HubertD/SAMC21-Base/SAMC21-Base.kicad_pcb

## KiCad design SAMC21-Base.kicad_pcb (2021-04-19)

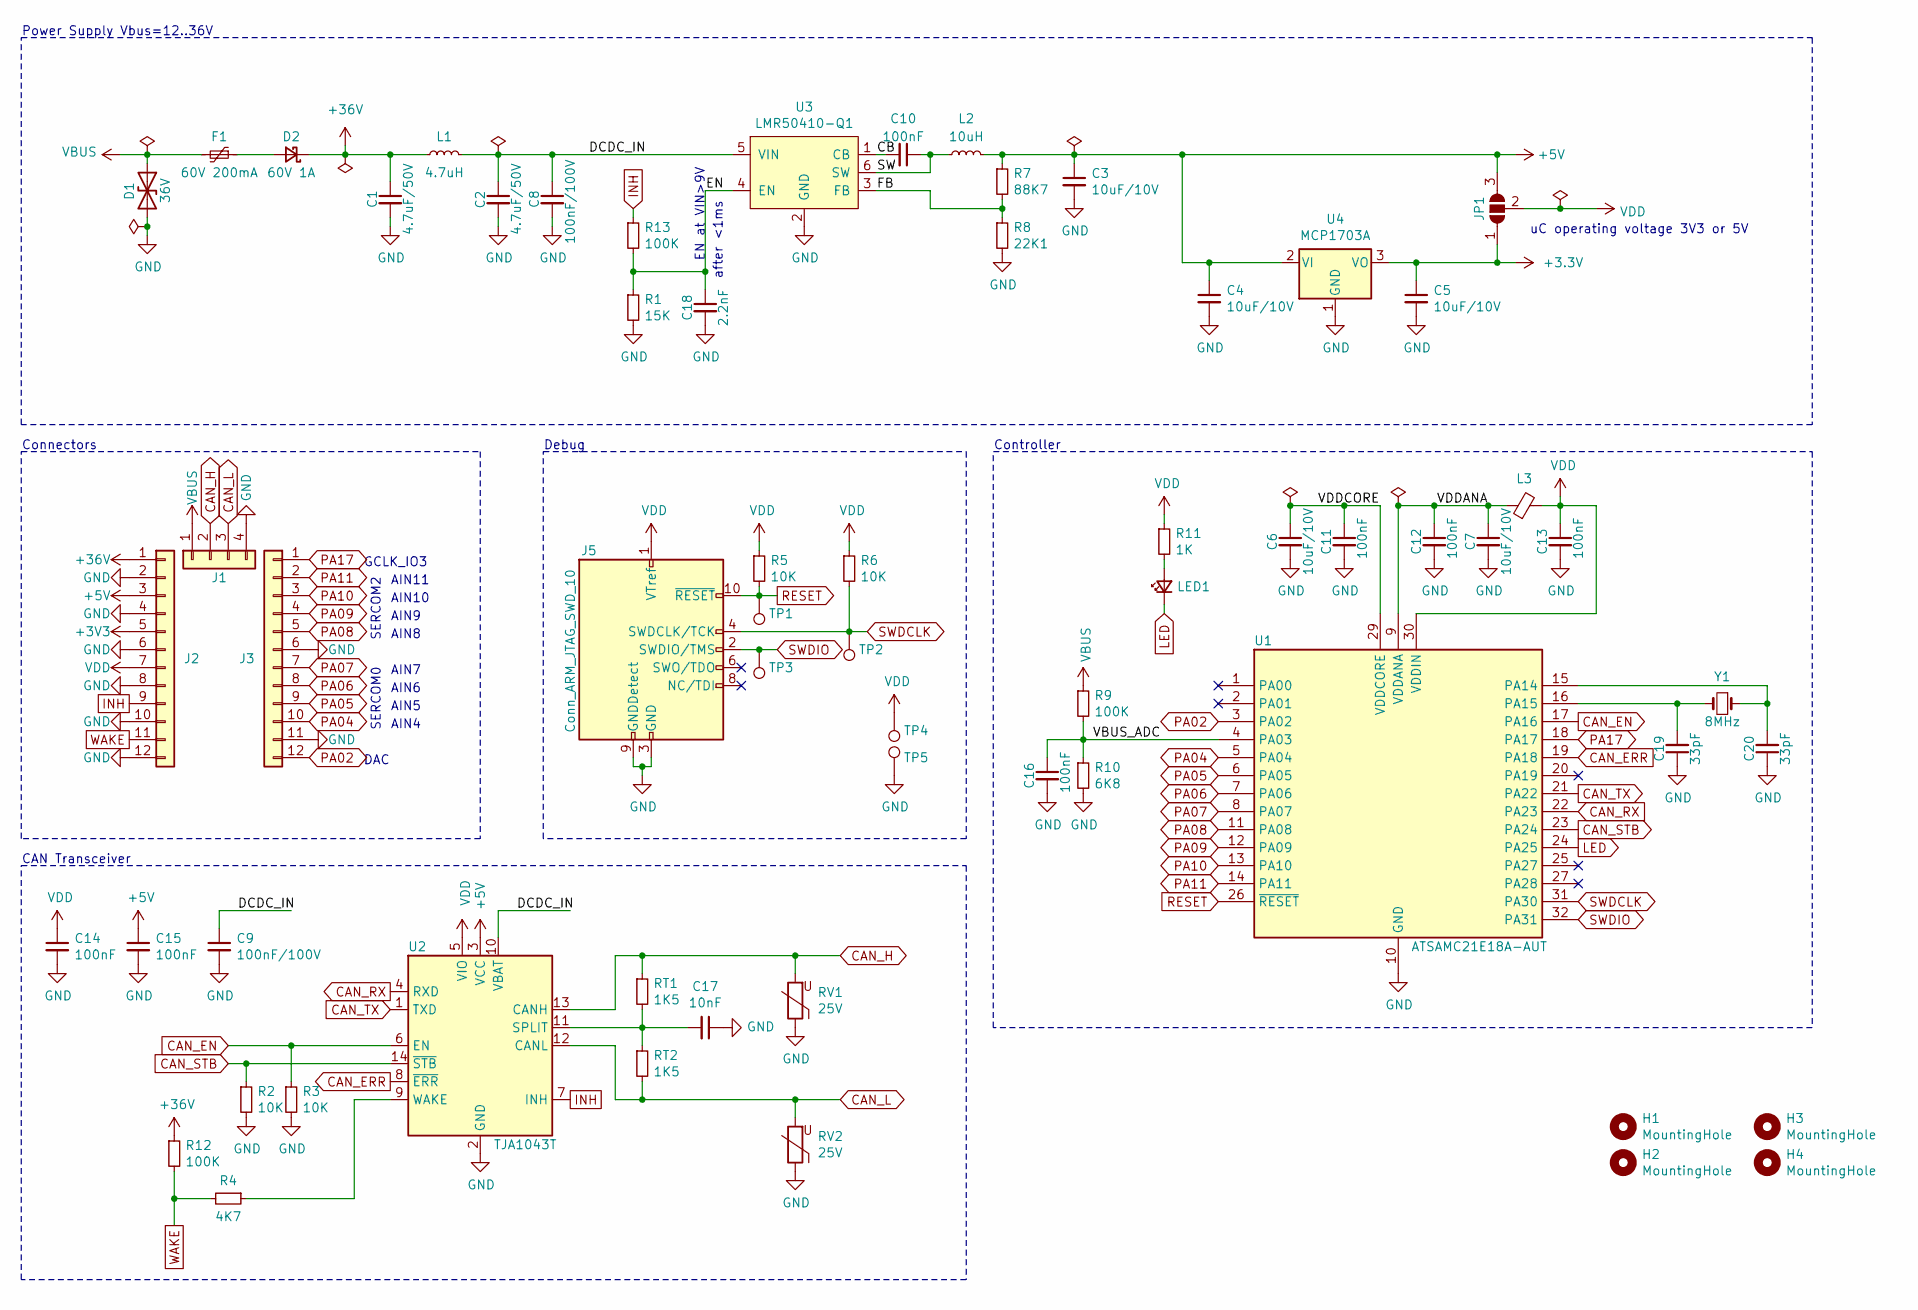
[picture p1: schematic SAMC21-Base.sch]

Parts:
C1, C2: 4.7uF/50V; C_1206_3216Metric
C3, C4, C5, C6, C7: 10uF/10V; C_0805_2012Metric
C8, C9: 100nF/100V; C_0603_1608Metric
C10, C11, C12, C13, C14, C15, C16: 100nF; C_0603_1608Metric
C17: 10nF; C_0603_1608Metric
C18: 2.2nF; C_0603_1608Metric
C19, C20: 33pF; C_0603_1608Metric
D1: 36V; D_SMA; MPN SMAJ36CA
D2: 60V 1A; D_SOD-123; MPN RB160MM-60TFTR
F1: 60V 200mA; Fuse_1812_4532Metric; MPN 1812L020/60
H1, H2, H3, H4: MountingHole; MountingHole_2.2mm_M2
J1: Conn_01x04; PinHeader_1x04_P2.54mm_Vertical
J2, J3: Conn_01x10; PinHeader_1x12_P2.54mm_Vertical
J5: Conn_ARM_JTAG_SWD_10; PinHeader_2x05_P1.27mm_Vertical_SMD
JP1: SolderJumper_3_Open; SolderJumper-3_P1.3mm_Open_RoundedPad1.0x1.5mm
L1: 4.7uH; L_0805_2012Metric; MPN MLP2012V4R7MT0S1
L2: 10uH; L_Bourns-SRN4018; MPN SRN4018-100M
L3: 220R@100MHz; L_0603_1608Metric; MPN MPZ1608S221ATA00
LED1: LED_Small; LED_0603_1608Metric
R1: 15K; R_0603_1608Metric
R2, R3, R5, R6: 10K; R_0603_1608Metric
R4: 4K7; R_0603_1608Metric
R7: 88K7; R_0603_1608Metric
R8: 22K1; R_0603_1608Metric
R9, R12, R13: 100K; R_0603_1608Metric
R10: 6K8; R_0603_1608Metric
R11: 1K; R_0603_1608Metric
RT1, RT2: 1K5; R_0805_2012Metric
RV1, RV2: 25V; R_0805_2012Metric; MPN CT0805K25G
TP1, TP2, TP3, TP4, TP5: TestPoint; TestPoint_Pad_D1.5mm
U1: ATSAMC21E18A-AUT; TQFP-32_7x7mm_P0.8mm
U2: TJA1043T; SOIC-14_3.9x8.7mm_P1.27mm
U3: LMR50410-Q1; SOT-23-6
U4: MCP1703A; SOT-89-3
Y1: 8MHz; Crystal_SMD_Abracon_ABM3-2Pin_5.0x3.2mm; MPN ABM3-8.000MHZ-D2Y-T

Connections:
+5V: C3.1, C4.1, C15.1, J2.3, JP1.3 (B), L2.2, R7.1, U2.3 (VCC), U4.2 (VI)
+36V: C1.1, D2.1 (K), J2.1, L1.1, R12.1
/CB: C10.2, U3.1 (CB)
/DCDC_IN: C2.1, C8.1, C9.1, L1.2, U2.10 (VBAT), U3.5 (VIN)
/EN: C18.1, R1.1, R13.2, U3.4 (EN)
/FB: R7.2, R8.1, U3.3 (FB)
/SW: C10.1, L2.1, U3.6 (SW)
/VBUS_ADC: C16.1, R9.2, R10.1, U1.4 (PA03)
/VDDANA: C7.1, C12.1, L3.1, U1.9 (VDDANA)
/VDDCORE: C6.1, C11.1, U1.29 (VDDCORE)
CAN_EN: R3.1, U1.17 (PA16), U2.6 (EN)
CAN_ERR: U1.19 (PA18), U2.8 (~ERR)
CAN_H: J1.2, RT1.1, RV1.2, U2.13 (CANH)
CAN_L: J1.3, RT2.2, RV2.2, U2.12 (CANL)
CAN_RX: U1.22 (PA23), U2.4 (RXD)
CAN_STB: R2.1, U1.23 (PA24), U2.14 (~STB)
CAN_TX: U1.21 (PA22), U2.1 (TXD)
GND: C1.2, C2.2, C3.2, C4.2, C5.2, C6.2, C7.2, C8.2, C9.2, C11.2, C12.2, C13.2, C14.2, C15.2, C16.2, C17.1, C18.2, C19.1, C20.1, D1.2 (A2), J1.4, J2.2, J2.4, J2.6, J2.8, J2.10, J2.12, J3.6, J3.11, J5.3 (GND), J5.5 (GND), J5.9 (GNDDetect), R1.2, R2.2, R3.2, R8.2, R10.2, RV1.1, RV2.1, TP5.1, U1.10 (GND), U1.28 (GND), U2.2 (GND), U3.2 (GND), U4.1 (GND)
INH: J2.9, R13.1, U2.7 (INH)
LED: LED1.1 (K), U1.24 (PA25)
unnamed: C17.2, RT1.2, RT2.1, U2.11 (SPLIT)
unnamed: C19.2, U1.16 (PA15), Y1.2
unnamed: C20.2, U1.15 (PA14), Y1.1
unnamed: D2.2 (A), F1.1
unnamed: LED1.2 (A), R11.2
unnamed: R4.1, U2.9 (WAKE)
PA02: J3.12, U1.3 (PA02)
PA04: J3.10, U1.5 (PA04)
PA05: J3.9, U1.6 (PA05)
PA06: J3.8, U1.7 (PA06)
PA07: J3.7, U1.8 (PA07)
PA08: J3.5, U1.11 (PA08)
PA09: J3.4, U1.12 (PA09)
PA10: J3.3, U1.13 (PA10)
PA11: J3.2, U1.14 (PA11)
PA17: J3.1, U1.18 (PA17)
RESET: J5.10 (~RESET~), R5.2, TP1.1, U1.26 (~RESET)
SWDCLK: J5.4 (SWDCLK/TCK), R6.2, TP2.1, U1.31 (PA30)
SWDIO: J5.2 (SWDIO/TMS), TP3.1, U1.32 (PA31)
VBUS: D1.1 (A1), F1.2, J1.1, R9.1
VDD: C13.1, C14.1, J2.7, J5.1 (VTref), JP1.2 (C), L3.2, R5.1, R6.1, R11.1, TP4.1, U1.30 (VDDIN), U2.5 (VIO)
WAKE: J2.11, R4.2, R12.2

Notes on the sheet:
SERCOM0
AIN4
AIN5
AIN6
AIN7
SERCOM2
AIN8
AIN9
AIN10
AIN11
DAC
GCLK_IO3
Power Supply Vbus=12..36V
Connectors
Debug
CAN Transceiver
Controller
uC operating voltage 3V3 or 5V
EN at VIN>9V
after <1ms

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
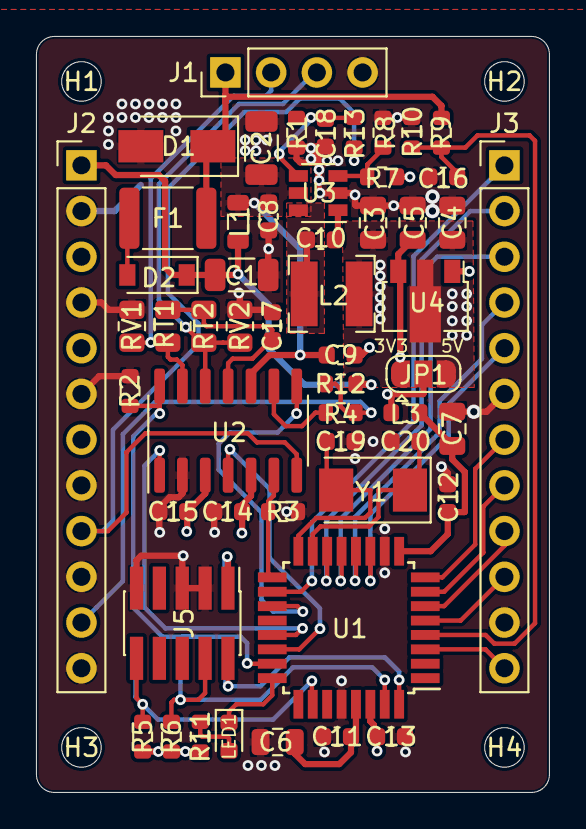
[picture p2: board SAMC21-Base.kicad_pcb from above]

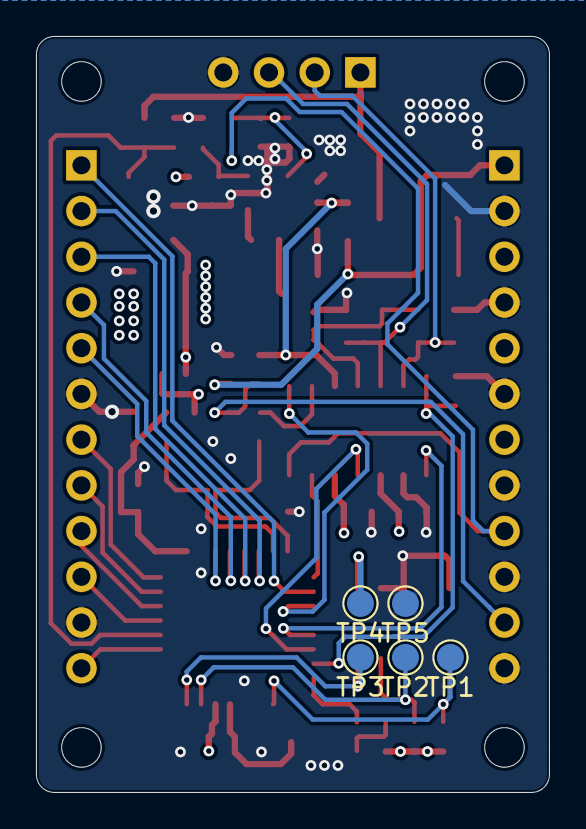
[picture p3: board SAMC21-Base.kicad_pcb from below]

Board: 4 copper layers, 28.5 x 42.0 mm, 63 parts (5 on the bottom side), 43 nets.
