HubertD/SAMC21-Base/(commit log)

2021-04-08 initial checkin
    [SAMC21-Base.kicad_pcb, SAMC21-Base.sch]
2021-04-08 specify ferrite bread
    [SAMC21-Base.sch]
2021-04-08 place ESD protection before polarity protection
    [SAMC21-Base.kicad_pcb, SAMC21-Base.sch]
2021-04-09 burn less energy on INH-pulldown
    [SAMC21-Base.sch]
2021-04-09 change small VIN capacitor rating to 100V
    [SAMC21-Base.sch]
2021-04-09 connect TJA1043 split pin
    [SAMC21-Base.kicad_pcb, SAMC21-Base.sch]
2021-04-09 specify crystal and crystal Cs
    [SAMC21-Base.sch]
2021-04-09 improve 3V3 routing
    [SAMC21-Base.kicad_pcb]
2021-04-09 improve routing
    [SAMC21-Base.kicad_pcb]
2021-04-09 change VBUS_ACC volatge divider
    [SAMC21-Base.kicad_pcb, SAMC21-Base.sch]
2021-04-10 add various ESD, EMV and overcurrent protections
    [SAMC21-Base.kicad_pcb, SAMC21-Base.sch]
2021-04-17 rework power stage, again.
    [SAMC21-Base.sch]
2021-04-18 polish schematics
    [SAMC21-Base.sch]
2021-04-18 redo layout. from scratch.
    [SAMC21-Base.kicad_pcb, SAMC21-Base.sch]
2021-04-18 minor cleanups
    [SAMC21-Base.kicad_pcb]
2021-04-19 cleanup after review-3
    [SAMC21-Base.kicad_pcb, SAMC21-Base.sch]
2021-04-19 use DCDC_IN for TJA1043 Vbat
    [SAMC21-Base.kicad_pcb, SAMC21-Base.sch]
